kraakenstuff/ADSR/README.md

# ADSR
2HP ADSR module based on "Fastest Envelope in the West" by René Schmitz (https://www.schmitzbits.de/adsr.html)

Status: Working fine.
