kraakenstuff/ADSR/ADSR.kicad_pcb

## KiCad design ADSR.kicad_pcb (2019-08-21)

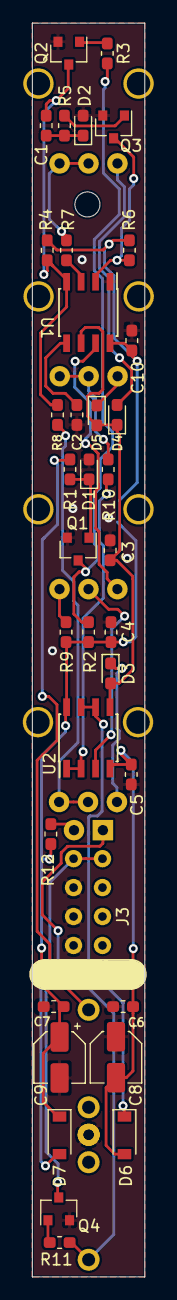
[picture p1: board ADSR.kicad_pcb from above]

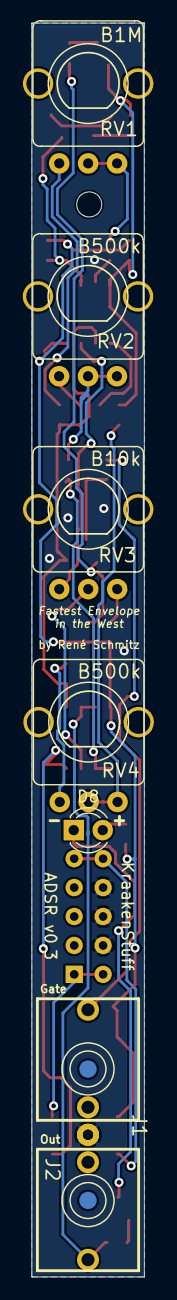
[picture p2: board ADSR.kicad_pcb from below]

Board: 2 copper layers, 9.9 x 110.1 mm, 43 parts (7 on the bottom side), 30 nets.

Parts:
C1, C2: 10n; C_0603_1608Metric_Pad1.05x0.95mm_HandSolder
C3: 2.2u; C_0603_1608Metric_Pad1.05x0.95mm_HandSolder
C4, C5, C6, C7, C10: 100n; C_0603_1608Metric_Pad1.05x0.95mm_HandSolder
C8, C9: 10u; CP_Elec_4x4.5
D1, D2, D3, D4, D5: 1n4148; D_0603_1608Metric_Pad1.05x0.95mm_HandSolder
D6, D7: 1N5819; D_SOD-123
D8: LED; LED_D3.0mm
J1: Gate; PJ301M-12-NoHole
J2: Out; PJ301M-12-NoHole
J3: EuroPower; EuroHeader10
Q1, Q2, Q3, Q4: MMBT3904; SOT-23
R1, R5: 10k; R_0603_1608Metric_Pad1.05x0.95mm_HandSolder
R2, R4, R6, R9: 4k7; R_0603_1608Metric_Pad1.05x0.95mm_HandSolder
R3: 22k; R_0603_1608Metric_Pad1.05x0.95mm_HandSolder
R7, R8, R10: 100R; R_0603_1608Metric_Pad1.05x0.95mm_HandSolder
R11: 100k; R_0603_1608Metric_Pad1.05x0.95mm_HandSolder
R12: 1k; R_0603_1608Metric_Pad1.05x0.95mm_HandSolder
RV1: B1M; POT-9MM-ALPHA
RV2, RV4: B500k; POT-9MM-ALPHA
RV3: B10k; POT-9MM-ALPHA
U1: NE555; SOIC-8_3.9x4.9mm_P1.27mm
U2: LM358; SOIC-8_3.9x4.9mm_P1.27mm

Connections:
+12V: C4.2, C7.2, C9.1, C10.1, D7.1, R2.2, R4.2, R6.2, R9.2, R12.1, U1.8, U2.8
-12V: C5.1, C6.1, C8.2, D6.2, U2.4
GND: C2.1, C3.1, C4.1, C5.2, C6.2, C7.1, C8.1, C9.2, C10.2, D1.2, D2.2, J1.S, J2.S, J3.4, J3.6, J3.8, Q1.2, Q2.2, Q3.2, Q4.2, U1.1
unnamed: C1.1, D2.1, R5.2
unnamed: C1.2, Q2.3, R4.1, R8.2, U1.4
unnamed: C2.2, U1.5
unnamed: C3.2, D3.2, D4.1, D5.2, U1.6, U2.5
unnamed: D1.1, Q1.1, R1.1
unnamed: D3.1, RV4.1
unnamed: D4.2, RV1.1
unnamed: D5.1, RV2.1
unnamed: D6.1, J3.2
unnamed: D7.2, J3.10
unnamed: D8.1, Q4.3
unnamed: D8.2, R12.2
unnamed: J1.T, R1.2
unnamed: J2.T, R11.2, U2.6, U2.7
unnamed: Q1.3, R2.1, R3.2
unnamed: Q2.1, R3.1
unnamed: Q3.1, R5.1
unnamed: Q3.3, R6.1, U1.2
unnamed: Q4.1, R11.1
unnamed: R7.1, RV1.2, RV1.3
unnamed: R7.2, U1.3
unnamed: R8.1, RV4.2, RV4.3
unnamed: R9.1, RV3.3
unnamed: R10.1, U2.1, U2.2
unnamed: R10.2, RV2.2, RV2.3
unnamed: RV3.1, U1.7
unnamed: RV3.2, U2.3
