kraakenstuff/ADSR/(threads)

Thread 1 (2019-08-26):

ADSR base pcb unconnected trace

justjoheinz, 2019-08-26:
Unfortunately I just ordered some PCBs after I noticed in the Kicad file that there is one unconnected trace near D6 which you can find by invoking the Design Rule Checks.

mannes, 2019-09-04:
@justjoheinz you probably need not worry, the traces should still connect through the power header solder holes. You can check that out in kicad too.
Have you received/tested the PCBs already?

justjoheinz, 2019-09-06:
I got them today and the ordered parts are on the way. Will do some measuring once I am home.

mannes, 2019-09-10:
I've ordered a couple PCBs too, will post back when i find out this is a problem or not :)

justjoheinz, 2019-10-01:
I build mine now but have not tested it yet as the panel pcb holes for the pots are to narrow and I will need to widen them.

Another issue was with the power connector. It was a very tight fit but worked.

supermorel, 2019-10-16:
So? Working or not?

mannes, 2019-10-24:
> So? Working or not?

Didn't get to building it myself yet, however i have seen several successful builds on the facebook eurorack diy group. Had no trouble test-fitting (Song Huei) pots and (shroud less) power connector though

kraakenstuff, 2021-09-10:
What's that unconnected trace near the D6?
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

Thread 3 (2021-02-28):

diode orientation

KeLaiFu, 2021-02-28:
I'm unsure how to orientate the 0603 diodes on this pcb, I've looked at the pcb in kicad and I can see theres a taper on one side of the symbol, is this the side to match with the line on the actual component?

lgrabenhorst, 2021-05-10:
Hey @KeLaiFu, did you manage to sort this out? I am also struggling with finding the correct orientation.

KeLaiFu, 2021-05-11:
Yeah, my assumptions were correct, the taper in the symbols within the kicad file showed the orientation. If you are unfamiliar with kicad you may need to google how to switch off individual layers to see the symbols, but its not a big deal.
