kraakenstuff/ADSR/(commit log)

2019-07-27 Added unfinished panel
    [ADSR-Panel.kicad_pcb]
2019-07-28 Finished panel
    [ADSR-Panel.kicad_pcb]
2019-08-21 v.0.3 - Fixed the pot and C3 values. Changed transistors to MBT3904
    [ADSR-B_Cu.gbr, ADSR-B_Mask.gbr, ADSR-B_Paste.gbr, ADSR-B_SilkS.gbr, ADSR-Edge_Cuts.gbr, ADSR-F_Cu.gbr, ADSR-F_Mask.gbr, ADSR-F_Paste.gbr]
2019-08-21 Added panel gerbers
    [ADSR-Panel-B_Cu.gbr, ADSR-Panel-B_Mask.gbr, ADSR-Panel-B_Paste.gbr, ADSR-Panel-B_SilkS.gbr, ADSR-Panel-Edge_Cuts.gbr, ADSR-Panel-F_Cu.gbr, ADSR-Panel-F_Mask.gbr, ADSR-Panel-F_Paste.gbr]
